Danjovic/Wolf/concept.jpg

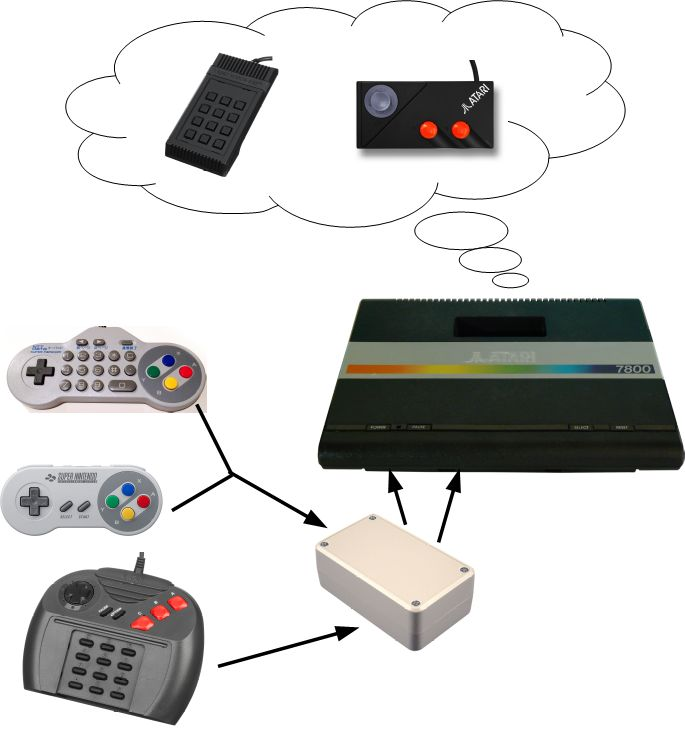
concept.jpg
