Danjovic/Wolf/README.md

# Wolf - Warning: Beta
Atari Jaguar/SNES controller adapter for emulate a Joystick and a Keypad for systems 2600 and 7800
