Danjovic/Wolf/buttons.pdf

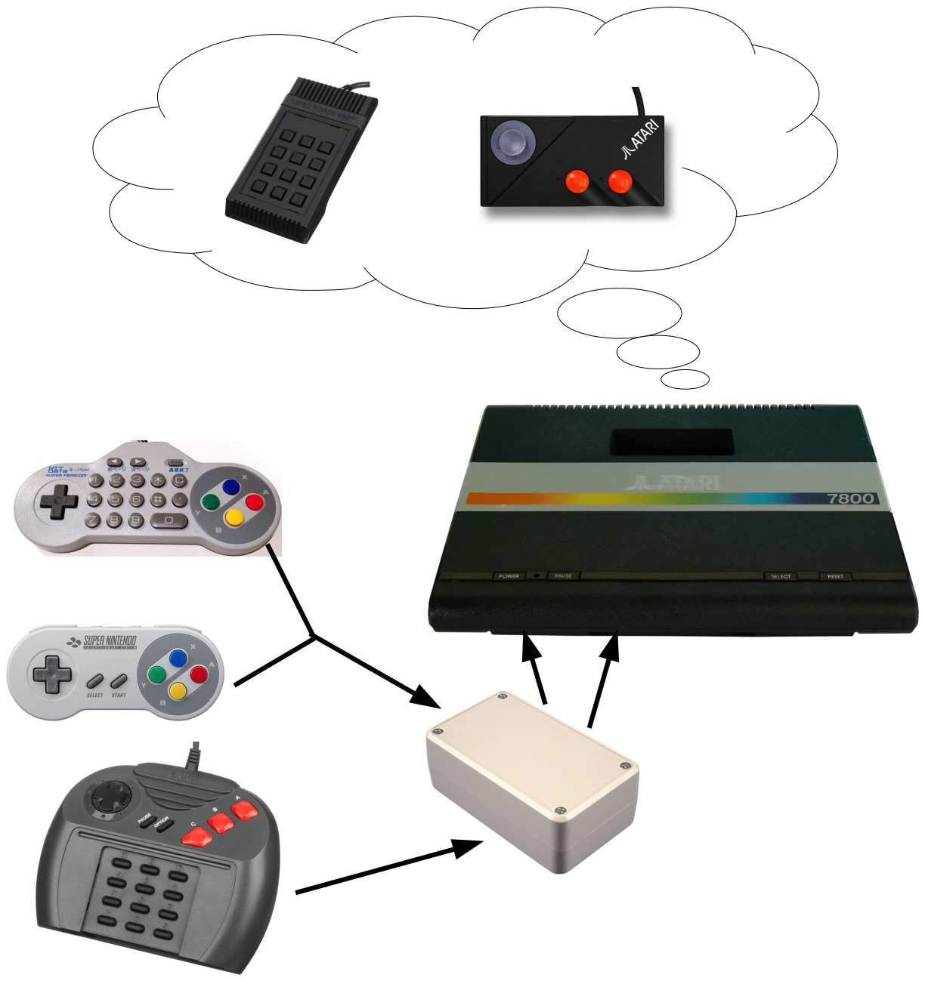
[picture p2: page 1]

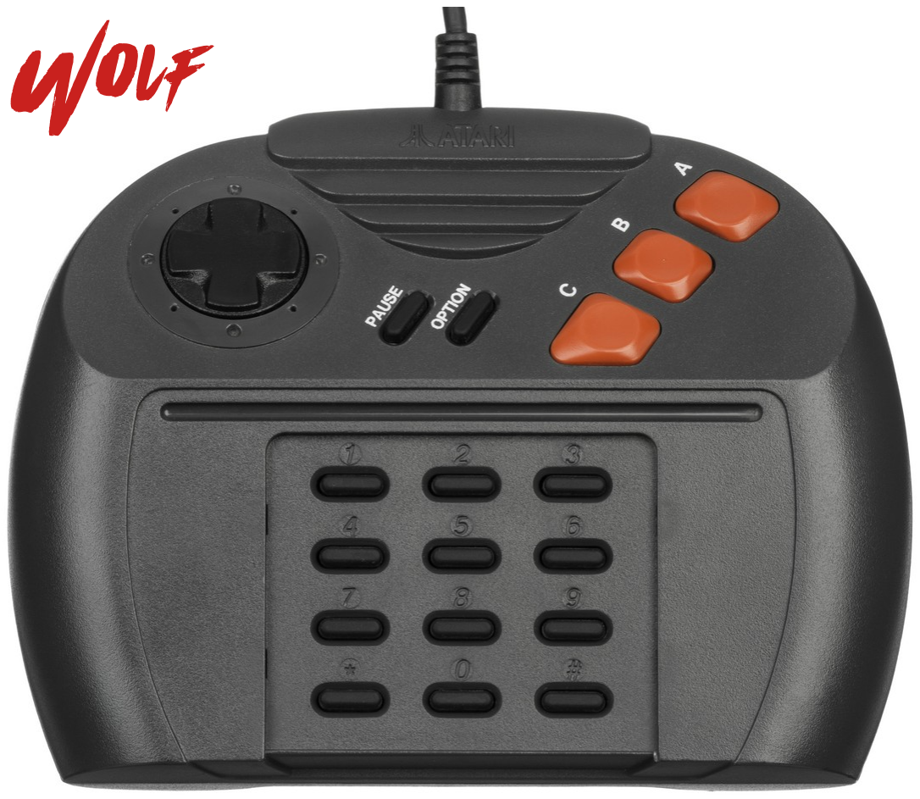
[picture p3: figure]
Wolf

MODE | C | B | A
2600 Omega Booster | Thumb (hi) | Trigger (hi) | Fire (low)
7800 Proline | Button 1 (hi) | Button 2 (hi) | Buttons 1+2
7800 Joy2B+ | Button 1 (low) | Button 2 (low) | Fire (low)

TRIGGER ACTION

== AT POWER UP ==
OPTION + UP → Omega Booster (2600) OPTION + LEFT → 7800 Proline OPTION + DOWN → 7800 Joy2B+

# Atari Jaguar Controller

# SNES Controller

== AT POWER UP ==
OPTION + UP → Omega Booster (2600) OPTION + LEFT → 7800 Proline OPTION + DOWN → 7800 Joy2B+ OPTION + RIGHT→ PetscII mode

BUTTON ACTION: PETSCII MODE

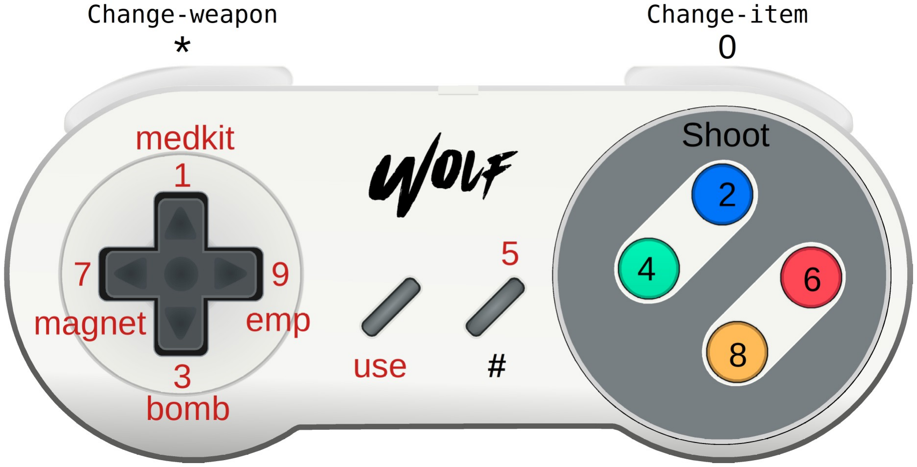
[picture p4: figure]

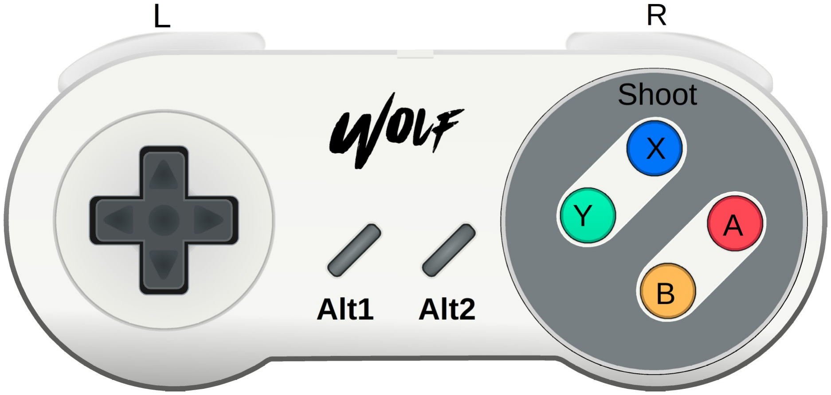
[picture p5: figure]

MODE | A | B | X | Y | L | R
2600 Omega Booster | Fire | Fire | Thumb (hi) | Thumb (hi) | Trigger (hi) | Trigger (hi)
7800 Proline | Buttons 1+2 | Buttons 1+2 | Button1 (hi) | Button1 (hi) | Button2 (hi) | Button2 (hi)
7800 Joy2B+ | Fire (low) | Fire (low) | Button1 (low) | Button1 (low) | Button2 (low) | Button2 (low)

OTHER MODES

TRIGGER ACTION

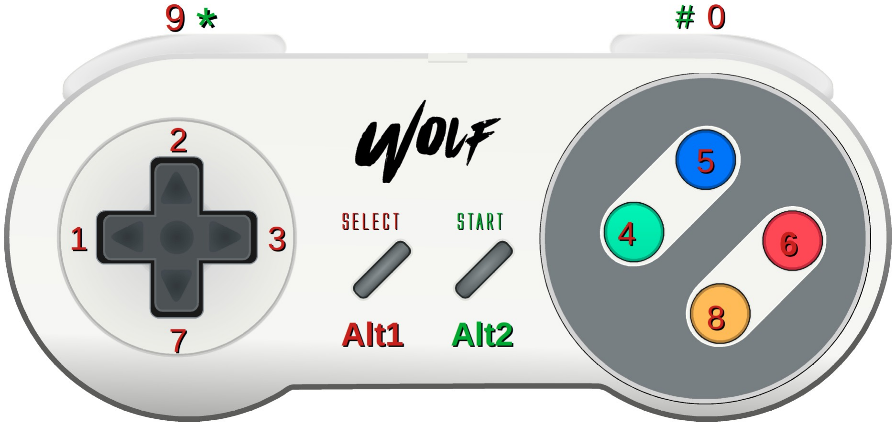
[picture p6: figure]

ALTERNATE FUNCTION

BUTTON ACTION: OTHER MODES

# SNES NTT KEYPAD CONTROLLER

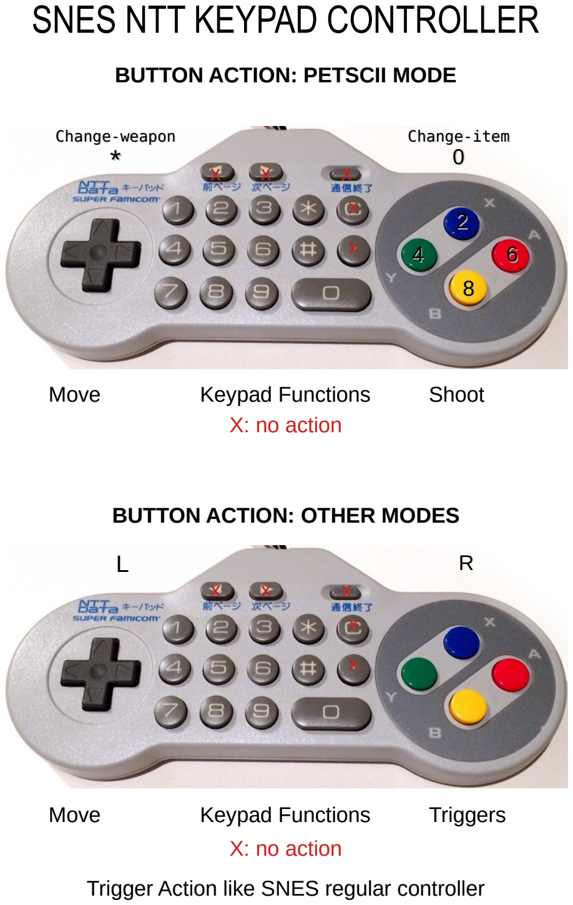
[picture p7: page 6]

BUTTON ACTION: PETSCII MODE

BUTTON ACTION: OTHER MODES

2
4 | 6
8

0 *

Change-weapon | Change-item
Move | Keypad Functions | Shoot
| x
| x
x | x | x

X: no action

L | R

Keypad Functions
X: no action

x
x
x | x | x
Move | Triggers

Trigger Action like SNES regular controller
