Danjovic/Wolf/doc/Wolf-PCB-for-RL6015.png

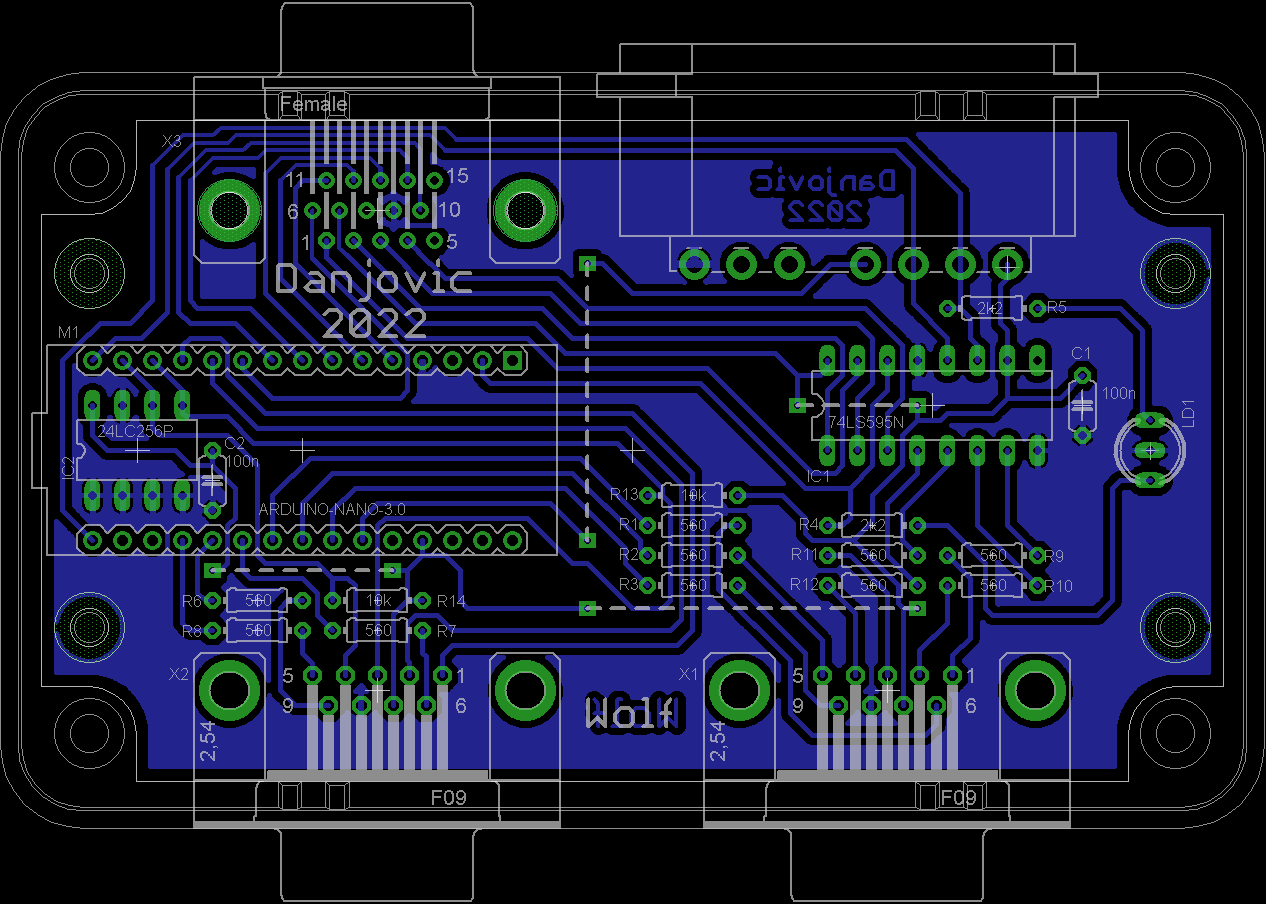
doc/Wolf-PCB-for-RL6015.png
