Danjovic/Wolf/doc/Wolf-Schematic.png

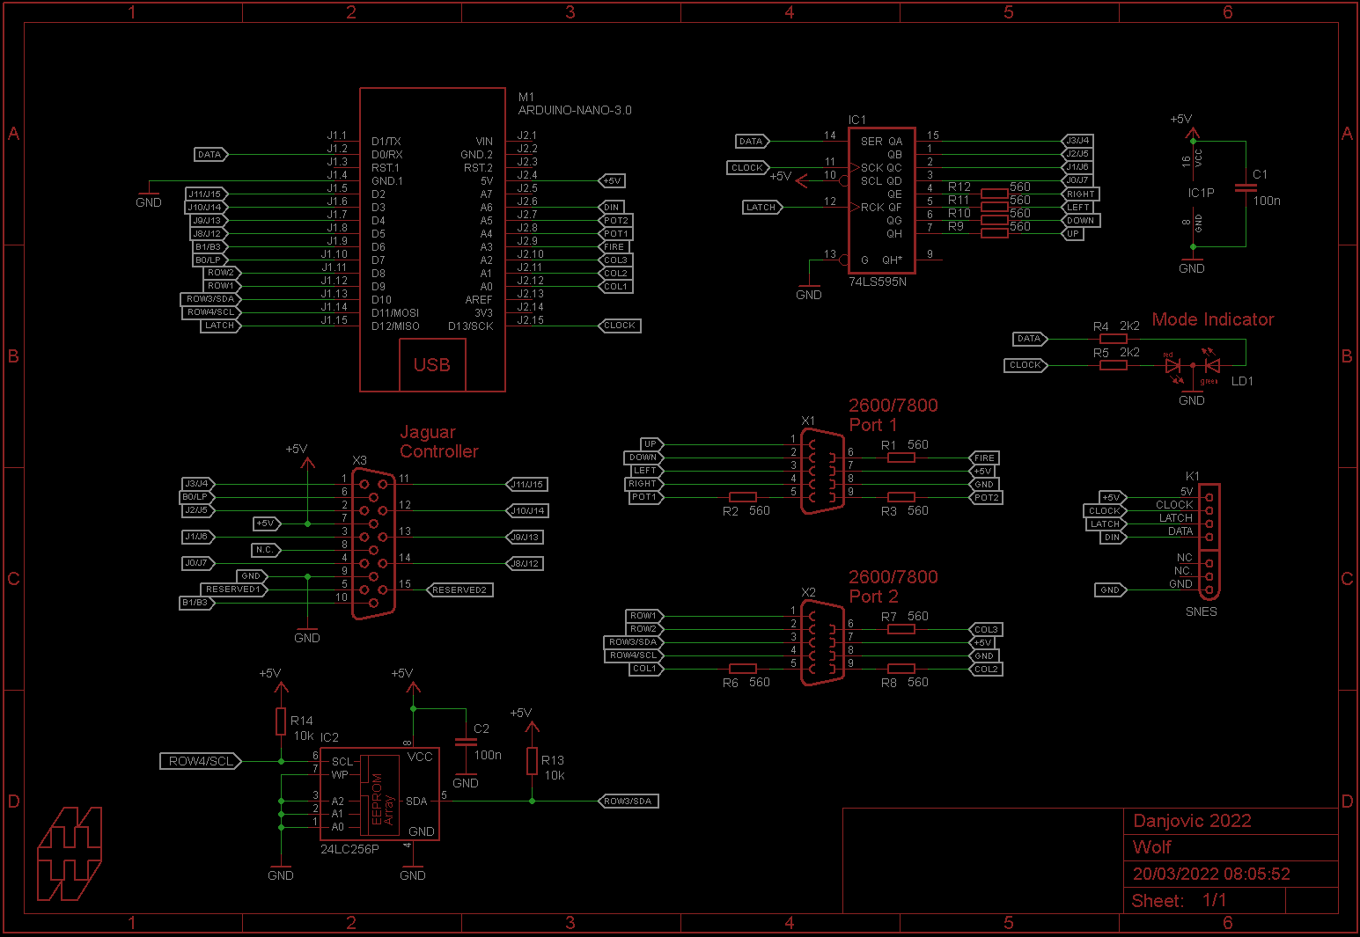
doc/Wolf-Schematic.png
