Danjovic/Wolf/doc/Wolf-Components.png

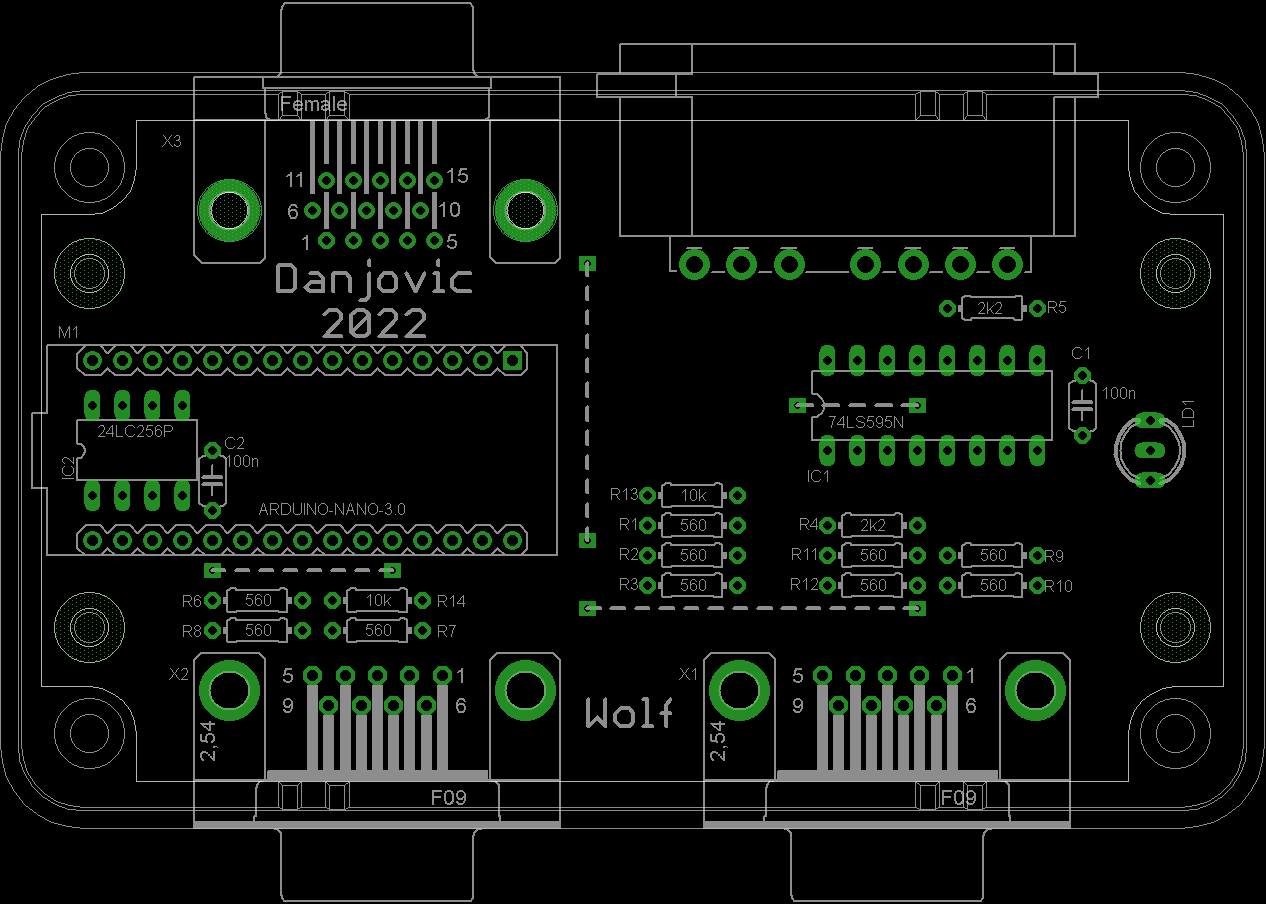
doc/Wolf-Components.png
