Danjovic/Wolf/circuit/Hoff.brd

## EAGLE design circuit/Hoff.brd (2022-04-12)

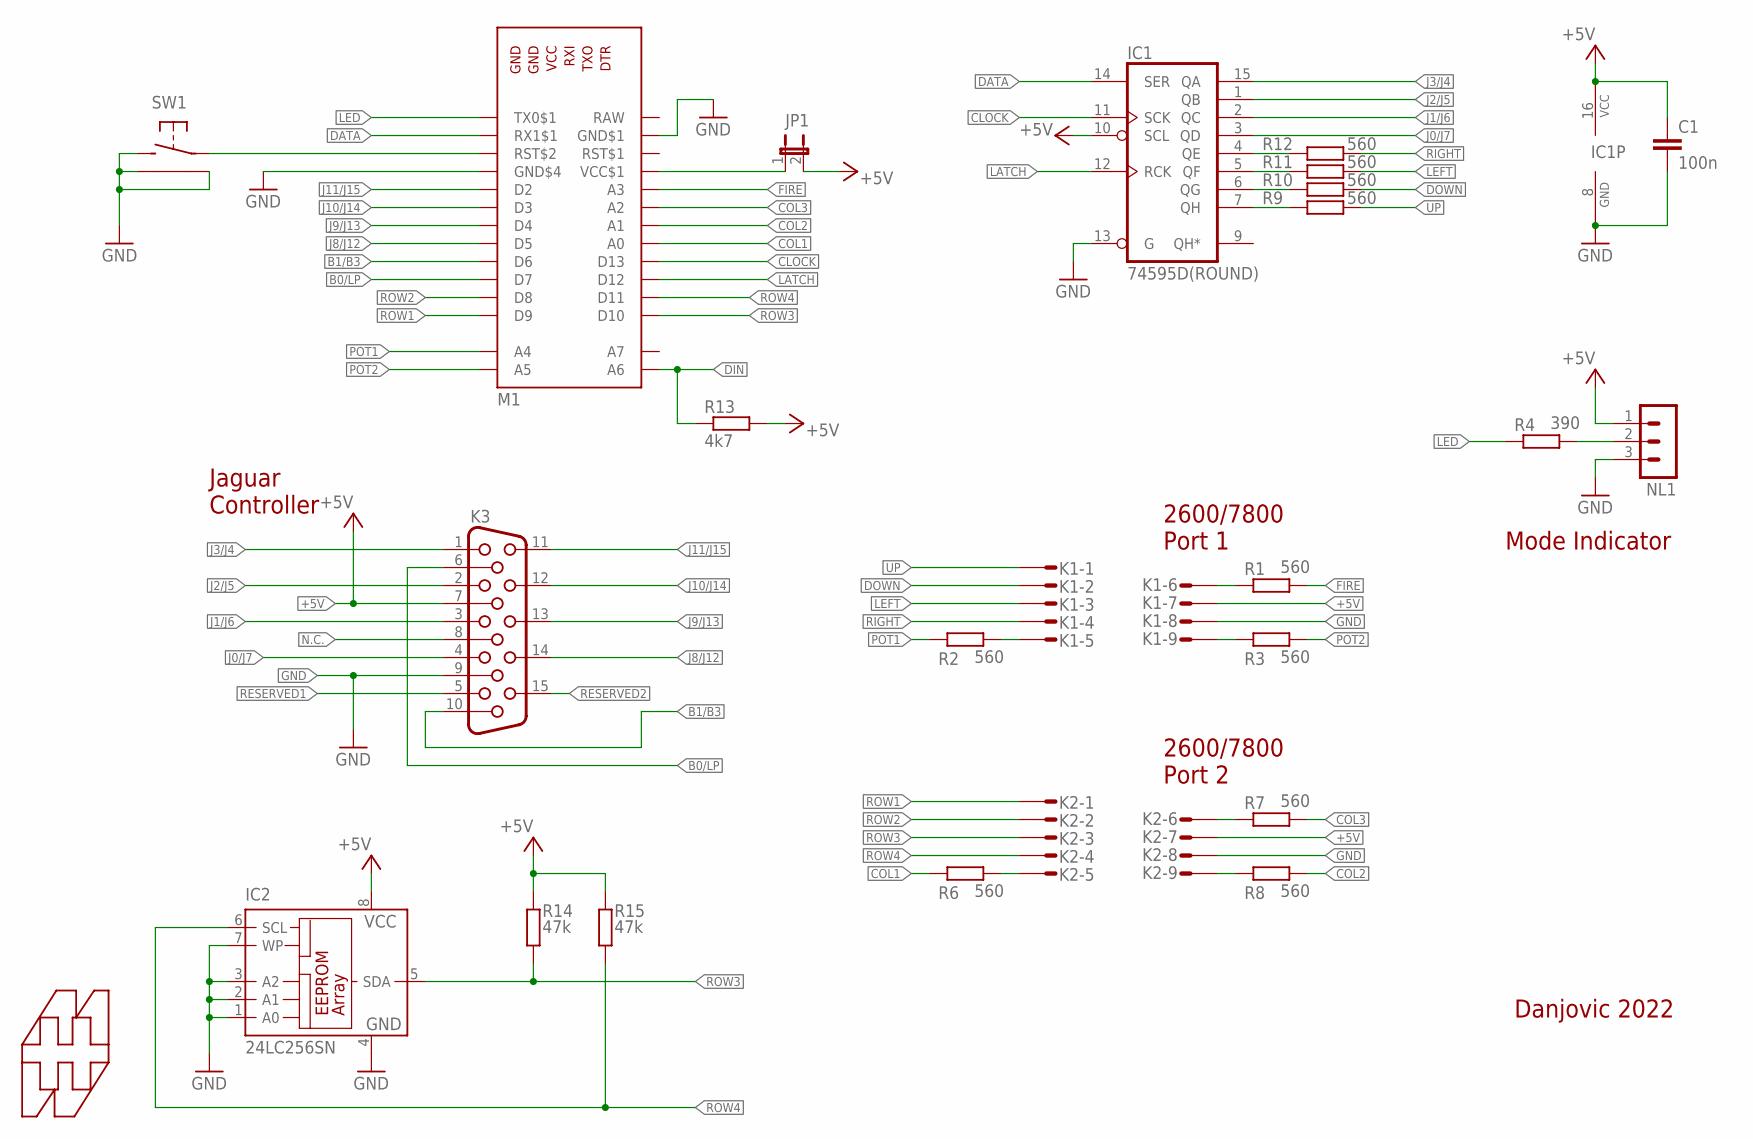
[picture p11: schematic Hoff.sch]

Parts:
C1: 100n; C050-024X044
IC1: 74595D(ROUND); DIL16-ROUND
IC2: 24LC256SN; SO-08
JP1: JP1E; JP1
K1, K2: S09P
K3: HF15H; HDF15H
M1: ARDUINO_PRO_MINI_SIDE_ONLY; ARDUNIO_PRO_MINI_SIDE_ONLY
NL1: MA03-1
R1, R2, R3, R6, R7, R8, R9, R10, R11, R12: 560; 0204/7
R4: 390; 0204/7
R13: 4k7; 0204/7
R14, R15: 47k; 0204/7
SW: 31-XX-GG; B3F-31XX
U$1: HAMMOND-1593J; 1593J

Connections:
!RESET: M1.RST$2, SW.1
+5V: C1.1, IC1.10 (SCL), IC1.16 (VCC), IC2.8 (VCC), JP1.2, K1.7, K2.7, K3.7, NL1.1, R13.2, R14.2, R15.2
B0/LP: K3.6, M1.D7
B1/B3: K3.10, M1.D6
CLOCK: IC1.11 (SCK), M1.D13
COL1: M1.A0, R6.1
COL2: M1.A1, R8.2
COL3: M1.A2, R7.2
DATA: IC1.14 (SER), M1.RX1$1
DIN: M1.A6, R13.1
DOWN: K1.2, R10.2
FIRE: M1.A3, R1.2
GND: C1.2, IC1.8 (GND), IC1.13 (G), IC2.1 (A0), IC2.2 (A1), IC2.3 (A2), IC2.4 (GND), IC2.7 (WP), K1.8, K2.8, K3.9, M1.GDN$1 (GND$1), M1.GND$4, NL1.3, SW.2 (S), SW.3, SW.4
J0/J7: IC1.3 (QD), K3.4
J1/J6: IC1.2 (QC), K3.3
J2/J5: IC1.1 (QB), K3.2
J3/J4: IC1.15 (QA), K3.1
J8/J12: K3.14, M1.D5
J9/J13: K3.13, M1.D4
J10/J14: K3.12, M1.D3
J11/J15: K3.11, M1.D2
LATCH: IC1.12 (RCK), M1.D12
LED: M1.TX0$1, R4.1
LEFT: K1.3, R11.2
unnamed: NL1.2, R4.2
unnamed: JP1.1, M1.VCC$1
N.C.: K3.8
POT1: M1.A4, R2.1
POT2: M1.A5, R3.2
RAW: M1.RAW
RESERVED1: K3.5
RESERVED2: K3.15
RIGHT: K1.4, R12.2
ROW1: K2.1, M1.D9
ROW2: K2.2, M1.D8
ROW3: IC2.5 (SDA), K2.3, M1.D10, R14.1
ROW4: IC2.6 (SCL), K2.4, M1.D11, R15.1
R_COL1: K2.5, R6.2
R_COL2: K2.9, R8.1
R_COL3: K2.6, R7.1
R_DOWN: IC1.6 (QG), R10.1
R_FIRE: K1.6, R1.1
R_LEFT: IC1.5 (QF), R11.1
R_POT1: K1.5, R2.2
R_POT2: K1.9, R3.1
R_RIGHT: IC1.4 (QE), R12.1
R_UP: IC1.7 (QH), R9.1
UP: K1.1, R9.2

Notes on the sheet:
Danjovic 2022
Jaguar Controller
2600/7800 Port 1
2600/7800 Port 2
Mode Indicator

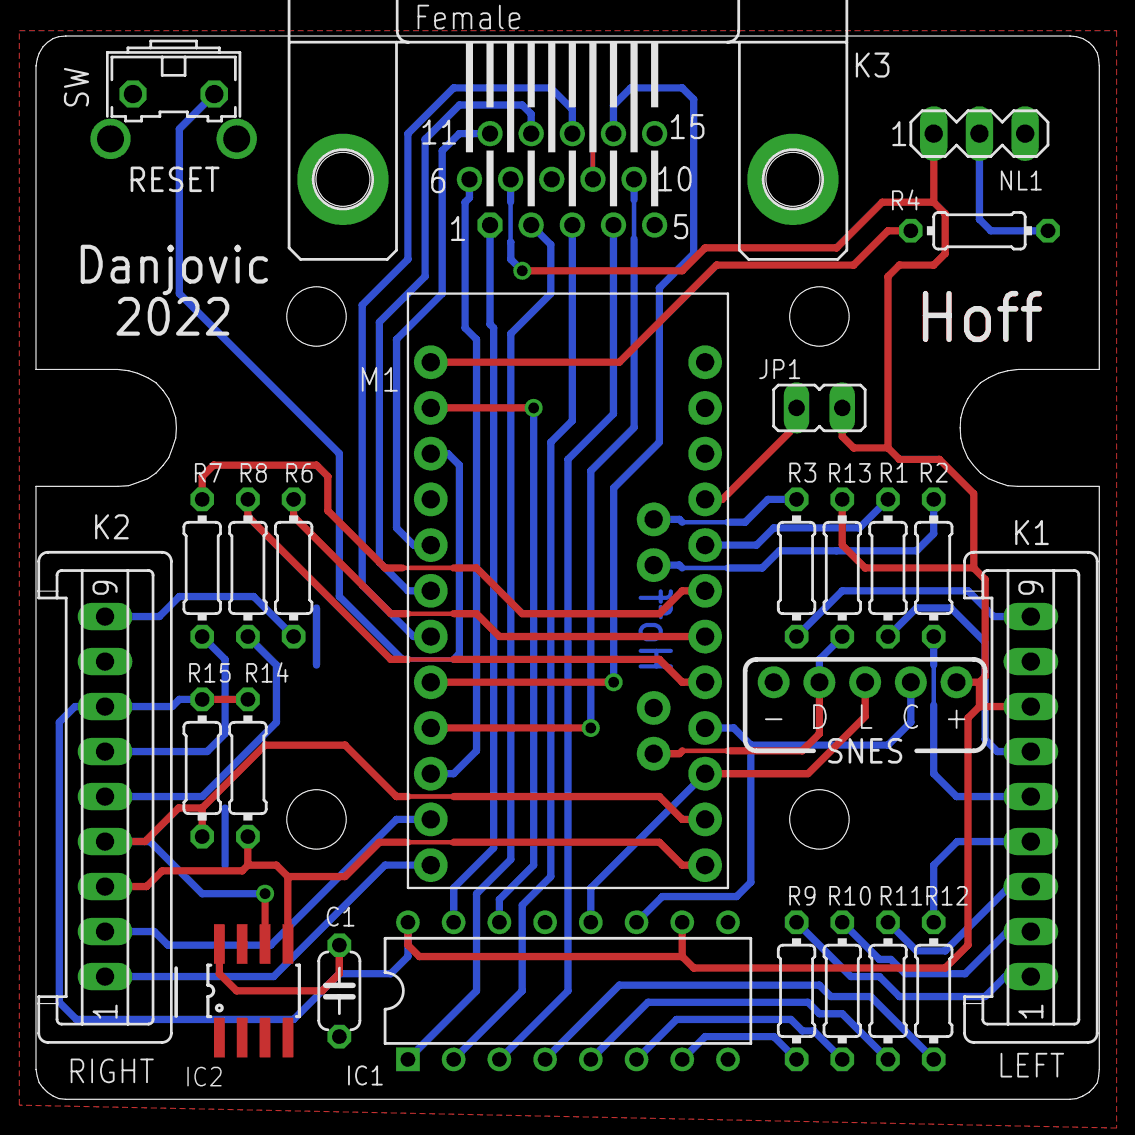
[picture p12: board Hoff.brd from above]

Board: 2 copper layers, 59.1 x 59.1 mm, 25 parts (0 on the bottom side), 44 nets.
