Danjovic/Wolf/circuit/Wolf.brd

## EAGLE design circuit/Wolf.brd (2022-04-12)

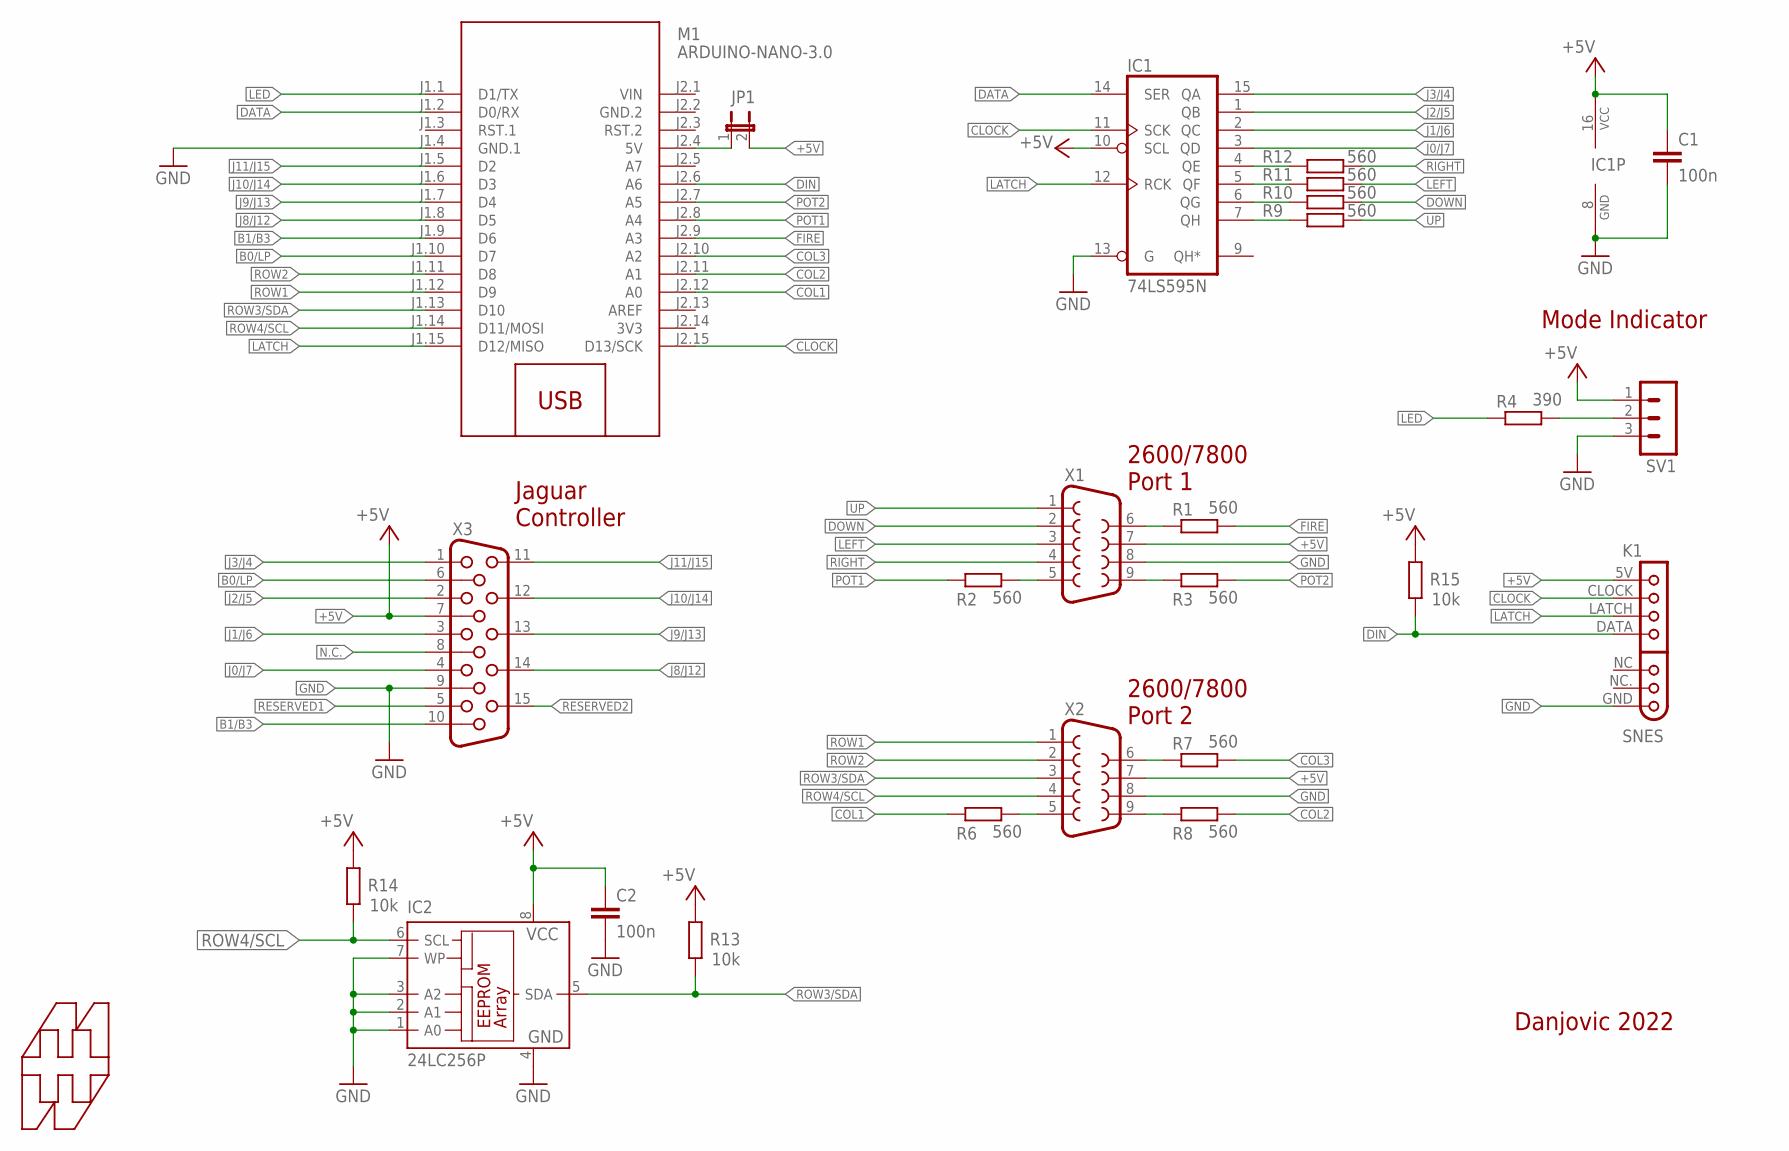
[picture p13: schematic Wolf.sch]

Parts:
C1, C2: 100n; C050-024X044
IC1: 74LS595N; DIL16
IC2: 24LC256P; DIL8
JP1: JP1E; JP1
K1: SNES; SNESCON-R
M1: ARDUINO-NANO-3.0
R1, R2, R3, R6, R7, R8, R9, R10, R11, R12: 560; 0204/7
R4: 390; 0204/7
R13, R14, R15: 10k; 0204/7
SV1: MA03-1
U$1: HAMMOND-RL6015; RL6015
X1, X2: F09HP
X3: HF15H; HDF15H

Connections:
3V3: M1.J2.14 (3V3)
+5V: C1.1, C2.1, IC1.10 (SCL), IC1.16 (VCC), IC2.8 (VCC), JP1.2, K1.5V (1), R13.2, R14.2, R15.2, SV1.1, X1.7, X2.7, X3.7
B0/LP: M1.J1.10 (D7), X3.6
B1/B3: M1.J1.9 (D6), X3.10
CLOCK: IC1.11 (SCK), K1.CLOCK (2), M1.J2.15 (D13/SCK)
COL1: M1.J2.12 (A0), R6.1
COL2: M1.J2.11 (A1), R8.2
COL3: M1.J2.10 (A2), R7.2
DATA: IC1.14 (SER), M1.J1.2 (D0/RX)
DIN: K1.DATA (4), M1.J2.6 (A6), R15.1
DOWN: R10.2, X1.2
FIRE: M1.J2.9 (A3), R1.2
GND: C1.2, C2.2, IC1.8 (GND), IC1.13 (G), IC2.1 (A0), IC2.2 (A1), IC2.3 (A2), IC2.4 (GND), IC2.7 (WP), K1.GND (7), M1.J1.4 (GND.1), SV1.3, X1.8, X2.8, X3.9
GND.2: M1.J2.2 (GND.2)
J0/J7: IC1.3 (QD), X3.4
J1/J6: IC1.2 (QC), X3.3
J2/J5: IC1.1 (QB), X3.2
J3/J4: IC1.15 (QA), X3.1
J8/J12: M1.J1.8 (D5), X3.14
J9/J13: M1.J1.7 (D4), X3.13
J10/J14: M1.J1.6 (D3), X3.12
J11/J15: M1.J1.5 (D2), X3.11
LATCH: IC1.12 (RCK), K1.LATCH (3), M1.J1.15 (D12/MISO)
LED: M1.J1.1 (D1/TX), R4.1
LEFT: R11.2, X1.3
unnamed: R4.2, SV1.2
N.C.: X3.8
POT1: M1.J2.8 (A4), R2.1
POT2: M1.J2.7 (A5), R3.2
RESERVED1: X3.5
RESERVED2: X3.15
RIGHT: R12.2, X1.4
ROW1: M1.J1.12 (D9), X2.1
ROW2: M1.J1.11 (D8), X2.2
ROW3/SDA: IC2.5 (SDA), M1.J1.13 (D10), R13.1, X2.3
ROW4/SCL: IC2.6 (SCL), M1.J1.14 (D11/MOSI), R14.1, X2.4
R_COL1: R6.2, X2.5
R_COL2: R8.1, X2.9
R_COL3: R7.1, X2.6
R_DOWN: IC1.6 (QG), R10.1
R_FIRE: R1.1, X1.6
R_LEFT: IC1.5 (QF), R11.1
R_POT1: R2.2, X1.5
R_POT2: R3.1, X1.9
R_RIGHT: IC1.4 (QE), R12.1
R_UP: IC1.7 (QH), R9.1
UP: R9.2, X1.1
VCC_ARD: JP1.1, M1.J2.4 (5V)
VIN: M1.J2.1 (VIN)

Notes on the sheet:
Danjovic 2022
Jaguar Controller
2600/7800 Port 1
2600/7800 Port 2
Mode Indicator

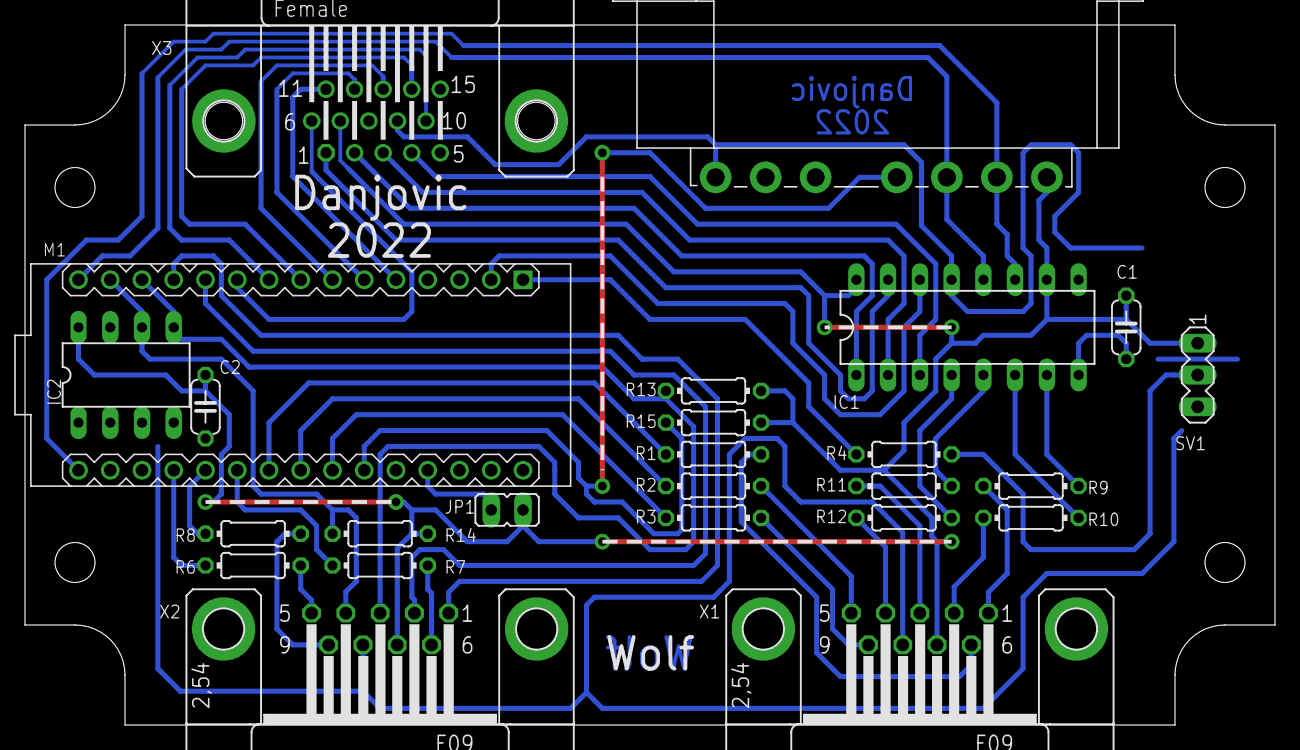
[picture p14: board Wolf.brd from above]

Board: 2 copper layers, 100.0 x 56.0 mm, 26 parts (0 on the bottom side), 43 nets.
