Danjovic/Wolf/(commit log)

2022-01-16 added contention protect resistors
    [Wolf.brd, Wolf.sch]
2022-01-16 updated indexes on sampleAndProcessControllerData() function
2022-01-17 updated pcb
    [Wolf.brd, Wolf.sch]
2022-01-17 added macros on button association logic
2022-02-26 Assed savekey eeprom to the circuit
    [Wolf.brd, Wolf.sch]
2022-03-20 Added missing GND connection
    [Wolf.brd, Wolf.sch]
2022-03-20 Changed resistor for bicolor LED
    [Wolf.brd, Wolf.sch]
2022-03-28 Shortened PCB
    [Cub.brd, Cub.sch]
2022-04-09 Beta
    Working with either Jaguar or SNES controller. Not working with both at the same time by now
    [Wolf.ino]
2022-04-12 Added neopixel to indicate operating mode
    [Hoff.brd, Hoff.sch, Wolf.brd, Wolf.sch]
